madhav-sawant/quadcopter-flight-controller/docs/graphs/angle_mode_bode.png

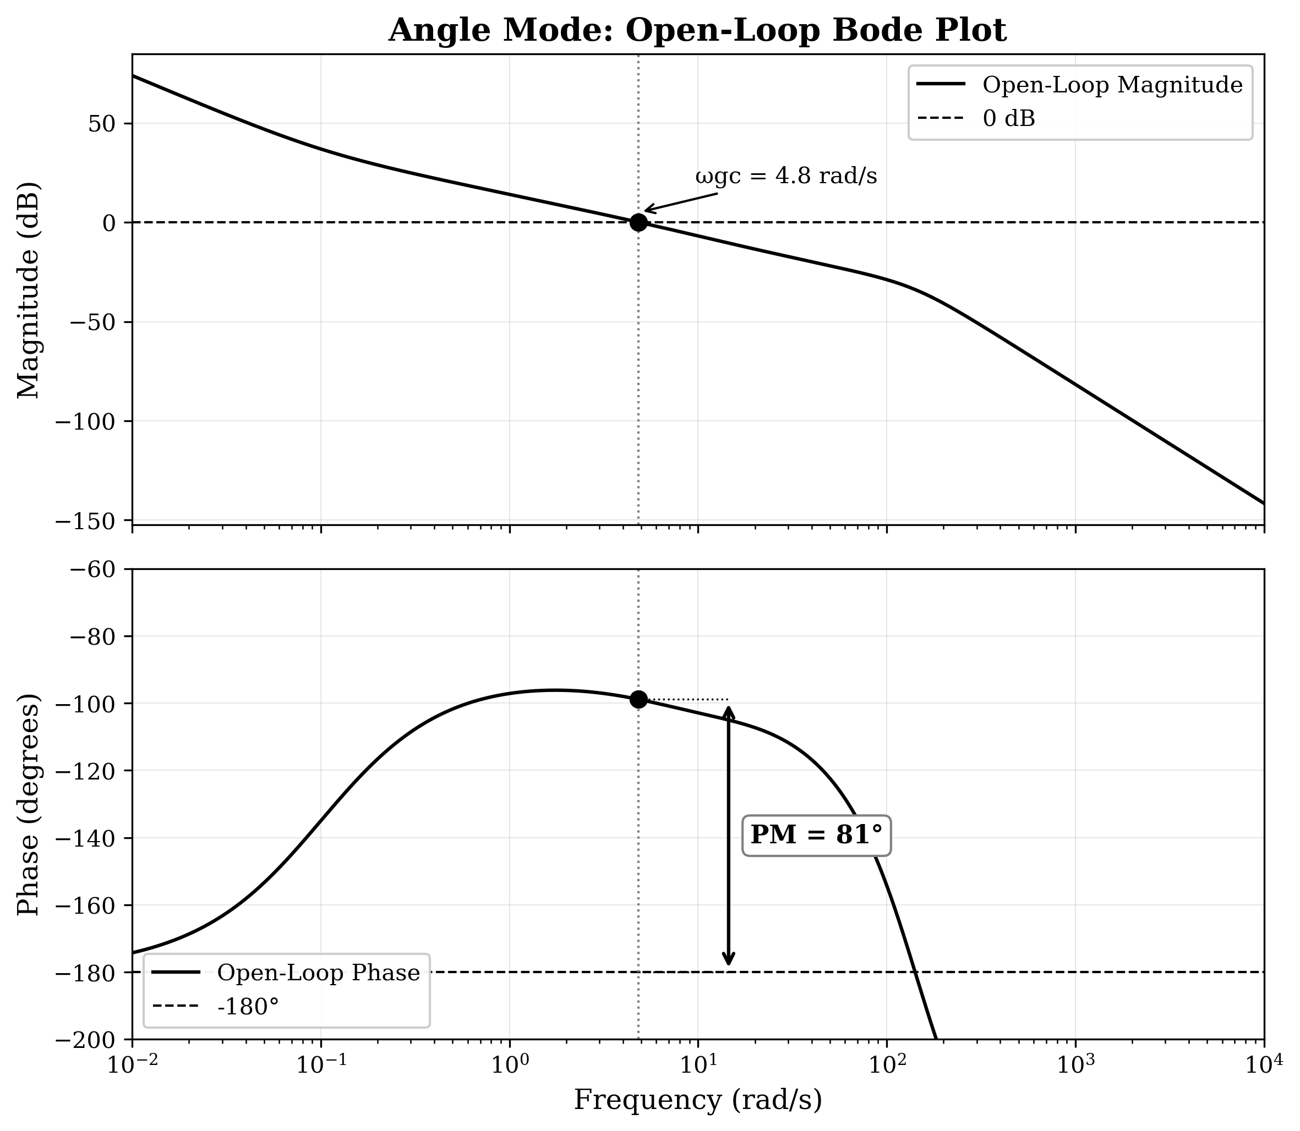
docs/graphs/angle_mode_bode.png
