madhav-sawant/quadcopter-flight-controller/docs/graphs/angle_mode_s_plane.png

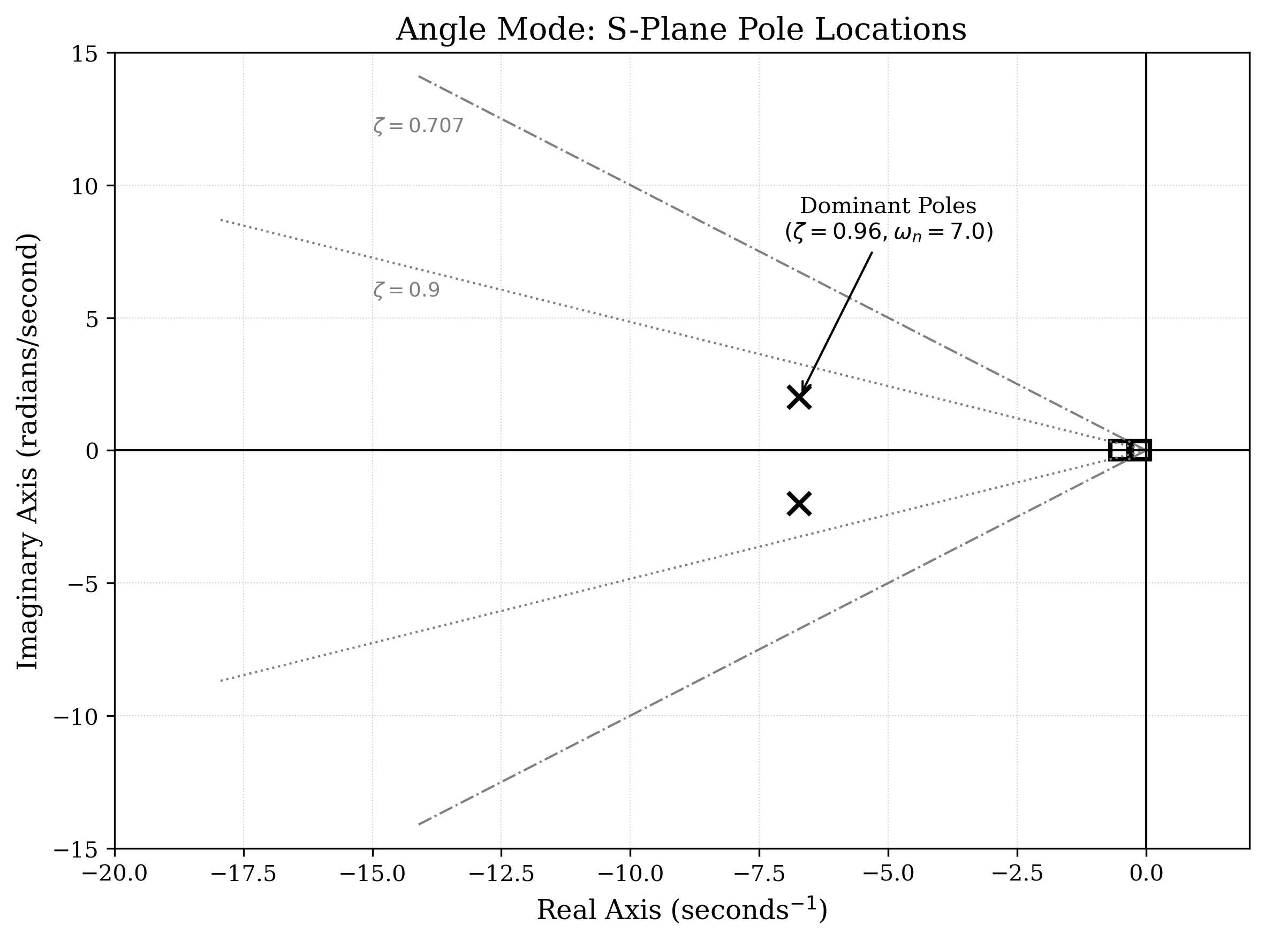
docs/graphs/angle_mode_s_plane.png
