madhav-sawant/quadcopter-flight-controller/docs/graphs/rate_vs_angle_comparison.png

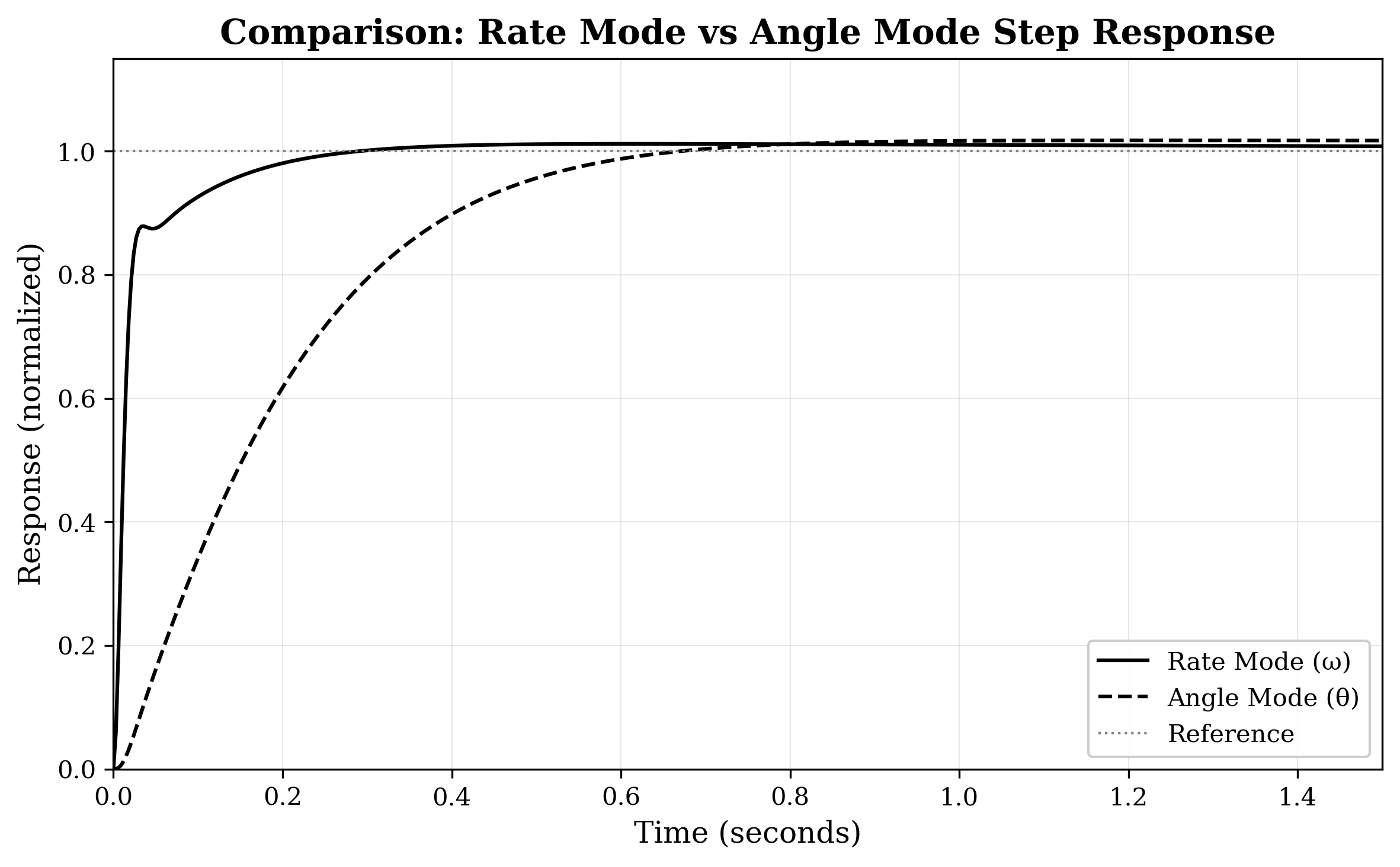
docs/graphs/rate_vs_angle_comparison.png
