madhav-sawant/quadcopter-flight-controller/docs/graphs/angle_mode_step_response.png

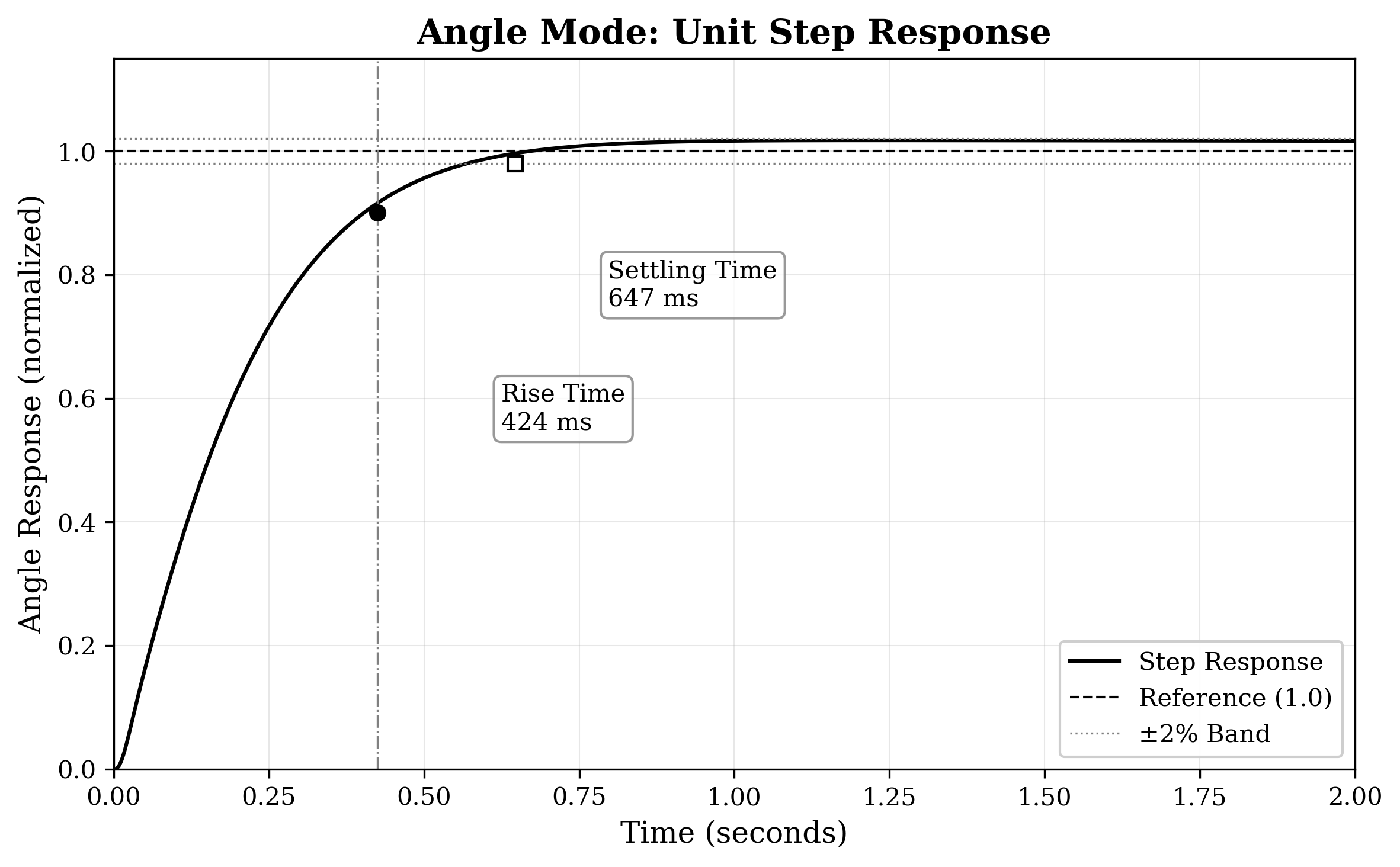
docs/graphs/angle_mode_step_response.png
