madhav-sawant/quadcopter-flight-controller/blackbox/fine-tuning need/blackbox (17).csv

time_ms | flags | gyro_x | gyro_y | gyro_z | accel_x | accel_y | accel_z | roll | pitch | rate_sp_roll | rate_sp_pitch | rate_err_roll | rate_err_pitch | rate_i_roll | rate_i_pitch | rate_i_yaw | pid_roll | pid_pitch | pid_yaw | m1 | m2 | m3 | m4 | rc_thr | rc_roll | rc_pitch | battery_mv | loop_us
125709 | 0 | -0.00 | -0.01 | 0.05 | 0.042 | -0.027 | 1.001 | 0.00 | 0.00 | -0.24 | -0.33 | -0.24 | -0.32 | -0.00 | -0.00 | -0.00 | -0.08 | -0.12 | -0.13 | 1000 | 1000 | 1000 | 1000 | 1031 | 1496 | 1508 | 12427 | 711
125721 | 0 | 0.05 | 0.01 | -0.01 | 0.042 | -0.027 | 1.001 | 0.00 | 0.00 | -0.24 | -0.33 | -0.30 | -0.33 | -0.00 | -0.00 | -0.00 | -0.12 | -0.19 | 0.03 | 1000 | 1000 | 1000 | 1000 | 1031 | 1496 | 1507 | 12432 | 711
125733 | 0 | 0.06 | -0.02 | 0.01 | 0.042 | -0.027 | 1.001 | 0.00 | 0.00 | -0.24 | -0.33 | -0.30 | -0.31 | -0.00 | -0.00 | -0.00 | -0.08 | -0.13 | -0.04 | 1100 | 1100 | 1100 | 1100 | 1031 | 1496 | 1507 | 12432 | 714
125745 | 0 | 0.02 | -0.01 | 0.03 | 0.042 | -0.026 | 1.000 | 0.00 | 0.00 | -0.25 | -0.33 | -0.26 | -0.32 | -0.00 | -0.00 | -0.00 | -0.03 | -0.14 | -0.07 | 1100 | 1100 | 1100 | 1100 | 1032 | 1497 | 1507 | 12427 | 714
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
