madhav-sawant/quadcopter-flight-controller/blackbox/fine-tuning need/blackbox (18).csv

time_ms | flags | gyro_x | gyro_y | gyro_z | accel_x | accel_y | accel_z | roll | pitch | rate_sp_roll | rate_sp_pitch | rate_err_roll | rate_err_pitch | rate_i_roll | rate_i_pitch | rate_i_yaw | pid_roll | pid_pitch | pid_yaw | m1 | m2 | m3 | m4 | rc_thr | rc_roll | rc_pitch | battery_mv | loop_us
60749 | 0 | -0.01 | 0.01 | -0.02 | 0.038 | -0.028 | 1.000 | 0.00 | 0.00 | 0.01 | 0.03 | 0.02 | 0.02 | 0.00 | 0.00 | 0.00 | 0.02 | -0.04 | 0.06 | 1100 | 1100 | 1100 | 1100 | 1035 | 1496 | 1505 | 12498 | 726
60761 | 0 | -0.01 | -0.03 | -0.01 | 0.039 | -0.029 | 1.000 | 0.00 | 0.00 | 0.01 | 0.03 | 0.02 | 0.06 | 0.00 | 0.00 | 0.00 | 0.01 | 0.14 | 0.03 | 1100 | 1100 | 1100 | 1100 | 1035 | 1496 | 1505 | 12498 | 726
60773 | 0 | -0.01 | 0.01 | -0.00 | 0.039 | -0.029 | 1.000 | 0.00 | 0.00 | 0.01 | 0.03 | 0.02 | 0.02 | 0.00 | 0.00 | 0.00 | 0.01 | -0.08 | 0.00 | 1100 | 1100 | 1100 | 1100 | 1036 | 1496 | 1505 | 12498 | 726
60785 | 0 | -0.03 | 0.00 | -0.02 | 0.039 | -0.029 | 0.999 | 0.00 | 0.00 | 0.01 | 0.03 | 0.04 | 0.02 | 0.00 | 0.00 | 0.00 | 0.05 | -0.02 | 0.06 | 1100 | 1100 | 1100 | 1100 | 1036 | 1496 | 1505 | 12498 | 726
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
