madhav-sawant/quadcopter-flight-controller/blackbox/fine-tuning need/blackbox (19).csv

time_ms | flags | gyro_x | gyro_y | gyro_z | accel_x | accel_y | accel_z | roll | pitch | rate_sp_roll | rate_sp_pitch | rate_err_roll | rate_err_pitch | rate_i_roll | rate_i_pitch | rate_i_yaw | pid_roll | pid_pitch | pid_yaw | m1 | m2 | m3 | m4 | rc_thr | rc_roll | rc_pitch | battery_mv | loop_us
16318 | 0 | 0.00 | 0.02 | 0.00 | 0.032 | -0.018 | 1.000 | 0.00 | 0.00 | -0.02 | -0.02 | -0.03 | -0.04 | -0.00 | -0.00 | -0.00 | -0.02 | -0.15 | -0.01 | 1000 | 1000 | 1000 | 1000 | 1035 | 1497 | 1508 | 12373 | 720
16330 | 0 | 0.05 | 0.07 | -0.02 | 0.032 | -0.019 | 1.000 | 0.00 | 0.00 | -0.03 | -0.02 | -0.08 | -0.10 | -0.00 | -0.00 | -0.00 | -0.04 | -0.20 | 0.05 | 1100 | 1100 | 1100 | 1100 | 1035 | 1496 | 1508 | 12373 | 720
16342 | 0 | 0.02 | 0.01 | -0.02 | 0.032 | -0.018 | 1.000 | 0.00 | 0.00 | -0.03 | -0.03 | -0.05 | -0.04 | -0.00 | -0.00 | -0.00 | 0.04 | 0.13 | 0.06 | 1100 | 1100 | 1100 | 1100 | 1035 | 1496 | 1508 | 12373 | 720
16354 | 0 | -0.03 | -0.02 | 0.01 | 0.031 | -0.018 | 1.000 | 0.00 | 0.00 | -0.03 | -0.03 | 0.00 | -0.00 | -0.00 | -0.00 | -0.00 | 0.05 | 0.12 | -0.02 | 1100 | 1100 | 1100 | 1100 | 1055 | 1496 | 1508 | 12373 | 720
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
