madhav-sawant/quadcopter-flight-controller/blackbox/Tuning I think proper/blackbox (25).csv

time_ms | flags | gyro_x | gyro_y | gyro_z | accel_x | accel_y | accel_z | roll | pitch | rate_sp_roll | rate_sp_pitch | rate_err_roll | rate_err_pitch | rate_i_roll | rate_i_pitch | rate_i_yaw | pid_roll | pid_pitch | pid_yaw | m1 | m2 | m3 | m4 | rc_thr | rc_roll | rc_pitch | battery_mv | loop_us
185868 | 0 | 0.01 | 0.00 | -0.01 | 0.034 | -0.026 | 0.999 | 0.00 | 0.00 | 0.37 | -0.43 | 0.36 | -0.43 | 0.00 | -0.00 | 0.00 | 0.06 | -0.22 | 0.03 | 1000 | 1000 | 1000 | 1000 | 1031 | 1498 | 1522 | 11924 | 743
185880 | 0 | 0.00 | -0.02 | -0.00 | 0.034 | -0.026 | 0.999 | 0.00 | 0.00 | 0.37 | -0.43 | 0.37 | -0.41 | 0.00 | -0.00 | 0.00 | 0.07 | -0.15 | 0.00 | 1000 | 1000 | 1000 | 1000 | 1031 | 1498 | 1521 | 11924 | 743
185892 | 0 | 0.01 | -0.01 | 0.04 | 0.034 | -0.026 | 0.999 | 0.00 | 0.00 | 0.37 | -0.43 | 0.36 | -0.42 | 0.00 | -0.00 | 0.00 | 0.11 | -0.18 | -0.10 | 1000 | 1000 | 1000 | 1000 | 1031 | 1498 | 1521 | 11924 | 743
185904 | 0 | 0.05 | 0.01 | 0.02 | 0.035 | -0.025 | 0.999 | 0.00 | 0.00 | 0.37 | -0.43 | 0.32 | -0.45 | 0.00 | -0.01 | 0.00 | 0.03 | -0.24 | -0.04 | 1000 | 1000 | 1000 | 1000 | 1031 | 1499 | 1521 | 11924 | 743
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
