madhav-sawant/quadcopter-flight-controller/blackbox/Tuning I think proper/blackbox (26).csv

time_ms | flags | gyro_x | gyro_y | gyro_z | accel_x | accel_y | accel_z | roll | pitch | rate_sp_roll | rate_sp_pitch | rate_err_roll | rate_err_pitch | rate_i_roll | rate_i_pitch | rate_i_yaw | pid_roll | pid_pitch | pid_yaw | m1 | m2 | m3 | m4 | rc_thr | rc_roll | rc_pitch | battery_mv | loop_us
246988 | 0 | -0.04 | 0.00 | -0.01 | 0.045 | -0.029 | 0.999 | 0.00 | 0.00 | 0.00 | -0.02 | 0.04 | -0.02 | 0.00 | -0.00 | -0.00 | 0.04 | 0.01 | 0.02 | 1000 | 1000 | 1000 | 1000 | 1025 | 1499 | 1527 | 11849 | 710
247000 | 0 | 0.03 | -0.05 | 0.01 | 0.045 | -0.029 | 1.001 | 0.00 | 0.00 | 0.00 | -0.02 | -0.03 | 0.04 | 0.00 | -0.00 | 0.00 | -0.06 | 0.11 | -0.01 | 1000 | 1000 | 1000 | 1000 | 1025 | 1499 | 1527 | 11849 | 710
247012 | 0 | -0.02 | -0.00 | -0.02 | 0.045 | -0.029 | 1.000 | 0.00 | 0.00 | 0.00 | -0.02 | 0.02 | -0.01 | 0.00 | -0.00 | 0.00 | 0.03 | -0.06 | 0.04 | 1000 | 1000 | 1000 | 1000 | 1025 | 1499 | 1527 | 11849 | 710
247024 | 0 | -0.00 | 0.01 | 0.01 | 0.045 | -0.029 | 1.000 | 0.00 | 0.00 | 0.00 | -0.02 | 0.01 | -0.03 | 0.00 | -0.00 | 0.00 | -0.02 | -0.07 | -0.03 | 1100 | 1100 | 1100 | 1100 | 1032 | 1499 | 1520 | 11849 | 710
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
