madhav-sawant/quadcopter-flight-controller/blackbox/Tuning I think proper/blackbox (27).csv

time_ms | flags | gyro_x | gyro_y | gyro_z | accel_x | accel_y | accel_z | roll | pitch | rate_sp_roll | rate_sp_pitch | rate_err_roll | rate_err_pitch | rate_i_roll | rate_i_pitch | rate_i_yaw | pid_roll | pid_pitch | pid_yaw | m1 | m2 | m3 | m4 | rc_thr | rc_roll | rc_pitch | battery_mv | loop_us
108820 | 0 | -0.01 | -0.04 | 0.01 | 0.019 | -0.011 | 1.001 | 0.00 | 0.00 | 0.00 | 0.03 | 0.01 | 0.07 | -0.00 | 0.00 | 0.00 | 0.02 | 0.12 | -0.02 | 1100 | 1100 | 1100 | 1100 | 1021 | 1499 | 1523 | 11732 | 721
108832 | 0 | 0.01 | -0.04 | 0.00 | 0.019 | -0.011 | 1.001 | 0.00 | 0.00 | 0.00 | 0.03 | -0.01 | 0.07 | 0.00 | 0.00 | -0.00 | -0.03 | 0.10 | -0.00 | 1100 | 1100 | 1100 | 1100 | 1012 | 1499 | 1532 | 11732 | 721
108844 | 0 | -0.01 | -0.06 | -0.02 | 0.018 | -0.011 | 1.001 | 0.00 | 0.00 | -0.00 | 0.03 | 0.01 | 0.09 | 0.00 | 0.00 | -0.00 | 0.02 | 0.11 | 0.04 | 1100 | 1100 | 1100 | 1100 | 1012 | 1499 | 1532 | 11732 | 721
108856 | 0 | 0.01 | 0.05 | -0.02 | 0.018 | -0.011 | 1.001 | 0.00 | 0.00 | -0.00 | 0.03 | -0.01 | -0.02 | -0.00 | 0.00 | 0.00 | 0.00 | -0.28 | 0.05 | 1100 | 1100 | 1100 | 1100 | 1023 | 1499 | 1521 | 11732 | 721
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
