madhav-sawant/quadcopter-flight-controller/(commit log)

2025-12-26 Initial commit: ESP32 Quadcopter Flight Controller Firmware v1.1
2025-12-27 Fix: ESC boot timing, GPIO remapping (M2->25, M3->33), optimized loop
    [main.c]
2025-12-27 Codebase cleanup: Remove unused code, update PID defaults, add blackbox module
    Changes:
    - Removed unused files: docs/plot_graph.py, test/blackbox_test.c
    - Removed unused functions: mixer_is_armed(), webserver_is_running(), blackbox_is_recording()
    - Made adc_read_raw() and adc_read_voltage() static (internal only)
    - Removed unused macro BLACKBOX_FLAG_LOW_BAT
    - Removed unused ctype.h include and server_running variable
    - Removed blackbox_test build environment from platformio.ini
    - Updated PID defaults: P=0.8, I=0.2, D=0.05 (rate), Angle=0
    - Set PID output limit to 400
    - Added blackbox module for flight data logging
    - Added partitions.csv for flash layout
    - Updated DOCUMENTATION.md
    [partitions.csv]
2025-12-28 Fix: Invert Pitch and Yaw axes in motor mixer
    - Fixed pitch axis inversion causing forward flip on takeoff
    - Fixed yaw axis inversion causing uncontrolled spinning
    - Updated mixer comments to document axis corrections
    - Both axes now correctly respond to IMU gyro orientation
    Motor mixing now correctly handles:
    - M1/M4 (CCW props): -yaw_pid for proper counter-torque
    - M2/M3 (CW props): +yaw_pid for proper counter-torque
    - Pitch signs inverted to match IMU gyro_y orientation
2025-12-28 PID tuning session: Updated default values for stable flight
    Changes from 3.5hr tuning session (Dec 2024):
    Rate PID (inner loop):
    - Roll/Pitch P: 0.25 → 0.08 (reduced to prevent oscillation)
    - Roll/Pitch D: 0.30 → 0.08 (reduced to dampen oscillations)
    - Roll/Pitch I: 0.01 (unchanged)
    - Yaw P: 3.0 → 2.0 (smoother yaw response)
    Angle PID (outer loop):
    - Roll/Pitch P: 2.0 → 1.0 (gentler self-leveling)
    - Roll/Pitch I: 0.5 → 0.25 (helps correct drift)
    Bug fixes:
    - I-term windup fix: Reset integral to 0 when frozen (pid.c)
    - Added angle_control_freeze_integral() function
    - Increased throttle freeze threshold: 1150 → 1200
    Test results:
    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
    [main.c]
2025-12-28 docs: Add comprehensive PID tuning log
    Documents the entire 3.5hr tuning session including:
    - Tuning methodology (Manual Empirical with Blackbox Analysis)
    - Issues identified and fixed
    - Phase-by-phase progress
    - Final PID values
    - Next steps for continued tuning
2025-12-28 safety: Add throttle limit for terrace tuning
    Added TUNING_THROTTLE_LIMIT (1400us) to prevent drone from
    climbing too high during PID tuning on terrace/rooftop.
    - Limits max throttle from 2000 to 1400
    - Keeps drone at lower altitude for safe tuning
    - Change to 2000 after tuning is complete
    [main.c]
2025-12-28 docs: Add future logic for Angle Limiting & Recovery
    Saved architectural idea for:
    - 45 degree command limit
    - Active recovery zone (45-60 deg)
    - Pre-crash safety logic
    To be implemented after PID tuning is complete.
2025-12-31 Fix: Integral freeze threshold, duplicate logic, and PID tuning for F450
    [main.c]
2025-12-31 Simplify firmware to Rate-Only Control
    - Removed Angle Control Loop (lib/angle_control deleted)
    - Simplified RX input for direct Rate Setpoints
    - Simplified Blackbox logging (removed angle data)
    - Simplified Webserver (removed angle PID tuning)
    - Preserved safety features (Crash Detect, Low Bat, Kill Switch)
    [main.c]
2025-12-31 Stable Flight Firmware: PID Optimizations, Angle Mode Prep, and Documentation
    - Tuned PID loop for stable hover (tested)
    - Fixed D-Term phase lag (Alpha 0.15 -> 0.42)
    - Corrected Integral Windup limits (100 -> 50)
    - Adjusted Rate Output limits for safety (400 -> 110)
    - Added comprehensive system documentation in docs/
    - Prepared config structures for upcoming Angle Mode
    [main.c]
2025-12-31 Golden Release: Fresh Gyro Cal + LED Seq + EMI Fix (0.995 alpha) + Deadband 50
    [blackbox (1).csv, blackbox (12).csv, blackbox (13).csv, blackbox (14).csv, blackbox (15).csv, blackbox (16).csv, blackbox (17).csv, blackbox (18).csv]
2026-01-04 Cleanup: Reorganize codebase - move analysis files to analysis/ folder, remove old logs and temp files
    [blackbox (1).csv, blackbox (12).csv, blackbox (13).csv, blackbox (14).csv, blackbox (15).csv, blackbox (16).csv, blackbox (17).csv, blackbox (18).csv]
2026-01-07 Clean codebase with documentation and ground station
2026-01-12 Checkpoint: Stable Flight Controller (Angle+Rate). Baro/Laser ready but disabled.
    [blackbox (17).csv, blackbox (18).csv, blackbox (19).csv, blackbox (24).csv, blackbox (25).csv, blackbox (26).csv, blackbox (27).csv]
2026-01-13 Cleanup: Remove VL53L0X laser sensor code, restore clean flight controller
2026-01-13 Feat: Add VL53L0X driver & Laser+Baro sensor display demo
2026-01-13 Integrated Sensor Fusion (Latching Logic 15cm) into Flight Controller
